b26439-ai/Siddarth-lmsbot/Task3_PID_Control.docx

# Task 3 — PID Control

How PID applies to line following, and why this robot uses PD

Summary: PID control steers the robot by turning "how far the line is from the centre" into "how much faster one wheel should turn than the other". For this robot we use PD: proportional plus derivative, with the integral term set to zero. The implementation is in Task 9 (task9_line_follower.ino); this document explains the reasoning.

# 1. The control problem

The goal is to keep the line under the centre sensor. The error is the difference between where the line is and where we want it:

error = line position − target = position − 0

The line position comes from the weighted centroid of the five sensors (Task 1): −2 means the line is under the far-left sensor, 0 centred, +2 far right. A positive error means the line is to the right, so the robot must turn right.

# 2. The role of P, I and D

Term | What it reacts to | Effect on the robot | Too much / too little
P (proportional) | The present error: how far off-centre the line is now | Steers in proportion to the offset: a small drift gives a small turn, a big drift a big turn | Too much: fast side-to-side wobble and overshoot. Too little: slow, wide corners; can lose the line
I (integral) | The sum of all past errors | Removes a constant offset, such as one motor always being slightly weaker | Builds up on long curves, then overshoots on the next turn ("wind-up"); makes the robot sluggish to settle
D (derivative) | How fast the error is changing | Acts as a brake on the turn: as the robot swings back toward the line, the error shrinks fast, and D pushes the other way to stop it overshooting | Too much: twitchy, reacts to sensor noise. Too little: P's wobble is not damped

An analogy: steering a bicycle to follow a painted line. P is "turn the handlebar according to how far you are from the line". D is "if you are already heading back toward it quickly, ease off the handlebar so you don't cross over". I is "if you keep finding yourself slightly left, add a permanent nudge right".

# 3. Which configuration and why: PD

Option | Behaviour on a line follower | Verdict
P only | Follows the line but oscillates, especially at speed, because nothing damps the swing | Too wobbly for 90° junctions about 30 cm apart
PD | P steers, D damps; stable at higher speed and settles quickly after corners | Chosen
Full PID | I removes steady offsets, but a line follower rarely has one; the summed error winds up on curves and causes overshoot | Not needed; I kept in code with Ki = 0

The Task 9 code still contains the I term (KI = 0). If testing shows the robot always drifting to one side, because the two motors are not perfectly matched (likely without encoders), a small Ki such as 0.5 can be added. The integral is reset whenever the line is lost and found again.

# 4. From sensor readings to motor commands

1. Read and scale: each sensor's raw value (0–4095) is calibrated to 0–1000, where 1000 means directly over the line.
2. Position: weighted centroid = Σ(weight × reading) / Σ(readings), with weights −2, −1, 0, +1, +2.
3. Error: position − 0.
4. Correction: u = Kp × error + Ki × (sum of errors) + Kd × (error − previous error).
5. Wheel commands: left = base + u, right = base − u. A line to the right (positive u) speeds up the left wheel and slows the right, so the robot turns right toward the line.
6. Limit: if either command exceeds 255, both are scaled down by the same factor, so the turn is preserved.
7. Drive: the sign of each command sets the motor's direction pins, and its size sets the PWM speed.

## Worked example (Kp = 50, Ki = 0, Kd = 60, base = 150)

Step | Value
Scaled readings S1…S5 | 0, 0, 200, 1000, 200 (the line is under S4)
Position | (−2·0 − 1·0 + 0·200 + 1·1000 + 2·200) / 1400 = 1400 / 1400 = +1.000
Error | +1.000 (previous error was 0)
Correction u | 50 × 1.000 + 60 × (1.000 − 0) = 110
Wheel commands | left = 150 + 110 = 260, right = 150 − 110 = 40
Proportional limit | 260 > 255, so both × 255/260: left 255, right 39 → a firm right turn

# 5. Responding to oscillation

Symptom | Likely cause | Response
Fast wobble around the line | Kp too high | Lower Kp by 20–30%, or raise Kd
Slow, growing swings that overshoot corners | Kd too low | Raise Kd in steps of about 20
Jittery motors even on a straight line | Kd too high (amplifying sensor noise) | Lower Kd
Fine when slow, unstable when fast | Base speed too high for the gains | Lower the base speed, or re-tune at the new speed
Behaviour changes from run to run | Loop timing not fixed (D depends on it) or battery voltage changing | Keep a fixed loop period (10 ms); start every run on a charged battery

Tuning order: set Kd = 0 and raise Kp until the robot follows with a quick, small wobble. Then raise Kd until the wobble disappears. Then increase the base speed and repeat.

# 6. Responding to a lost line

- Detection: if the five scaled readings add up to less than 200, no sensor can see the line. The centroid is not calculated, which also avoids dividing by zero.
- Recovery: the robot remembers which side the line was last seen on and spins toward it at a fixed speed (PWM 120). This catches the common case of overshooting a sharp corner.
- Safe stop: if the line is not found within 300 ms, both motors stop rather than letting the robot wander off the arena.
- Re-acquiring: when the line reappears, the PID memory (previous error and integral) is reset. Otherwise the jump in error would produce a sudden derivative kick.

# 7. Code sketch

The core of the implementation (full program and test results in Task 9):

float computePID(float error) {

integral += error; // I: running sum (Ki = 0 here)

float derivative = error - lastError; // D: change since the last loop

lastError = error;

return KP * error + KI * integral + KD * derivative;

}

// inside controlStep(), when the line is found:

float error = position; // target is 0 (centred)

float correction = computePID(error);

float leftCmd = BASE_SPEED + correction;

float rightCmd = BASE_SPEED - correction;

clampSpeed(leftCmd, rightCmd); // proportional limit to 255

left = round(leftCmd); // loop() then calls

right = round(rightCmd); // driveMotors(left, right)

Task 3 — PID Control · page 1
