b26439-ai/Siddarth-lmsbot/Task5_Power_Budget.docx

# Task 5 — Power Budget & Battery Selection

LMS / Meshmerize robot, system as in the Task 4 BOM

Result: the robot draws about 0.57 A in a typical run and at most about 2.22 A if both motors stall (3.42 A with a pessimistic motor). The 2S 1000 mAh 30C LiPo runs it for about 78 minutes per charge, while one 5.5-minute match uses only about 53 mAh (5% of the pack). The pack can deliver 30 A, about 9× the worst case.

# 1. System and assumptions

Power path: 2S LiPo → XT60 → 3 A fuse → switch. The battery feeds the TB6612FNG motor supply (VM) directly, and feeds an MP1584 buck set to 5.0 V for the ESP32's 5V pin. The ESP32 board's regulator then makes 3.3 V for the ESP32, the Pololu QTRX-MD-08RC sensor, the TB6612FNG logic and the LED.

- Battery voltage: 7.4 V nominal (8.4 V full, 6.0 V empty). Totals use 7.4 V.
- Buck efficiency η = 85% (assumption; switching regulators of this type are typically 85–90%).
- 3.3 V loads pass through a linear regulator, so its input current equals its output current plus its own quiescent current. Every 3.3 V load is therefore also a 5 V load at the same current.
- Motor current is counted at the battery as if PWM were 100%. PWM (capped at about 71%) actually lowers the average battery current, so this is a safe overestimate.
- Derating factor 0.75 for runtime (from the task brief): batteries never deliver their full label capacity, and a LiPo should not be drained below about 3.0 V per cell.
- Figures marked (est.) are estimates to be replaced by multimeter measurements once the robot is built.

# 2. Current draw per component

Idle = powered on, motors stopped. Running = following the line. Peak = Wi-Fi transmitting, LED on and motors stalled.

Component | Rail | Idle (mA) | Running (mA) | Peak / stall (mA) | Basis
ESP32 chip | 3.3 V | 68 | 68 (Wi-Fi off) / 100 (Wi-Fi on) | 240 | Espressif figures via JLCPCB (https://jlcpcb.com/blog/esp32-power-consumption-explained): CPU 240 MHz radio off 30–68 mA; Wi-Fi receive 95–100 mA; Wi-Fi transmit peak 240 mA
ESP32 board overhead | 3.3 V / 5 V | 8 | 8 | 8 | Regulator quiescent ~5 mA, power LED ~1.3 mA, USB chip ~1.3 mA (JLCPCB (https://jlcpcb.com/blog/esp32-power-consumption-explained))
Pololu QTRX-MD-08RC | 3.3 V | 17 | 17 | 17 | Maximum board current, all LEDs on (MG Super Labs (https://www.mgsuperlabs.co.in/estore/QTRX-MD-08RC-Reflectance-Sensor-Array-8-Channel-8mm-Pitch-RC-Output-Low-Current))
TB6612FNG logic (VCC) | 3.3 V | 1.1 | 1.1 | 1.8 | ICC 1.1 mA typ, 1.8 mA max at 3 V (Toshiba (https://toshiba.semicon-storage.com/info/docget.jsp?did=10660) p. 5)
Red end-zone LED | 3.3 V | 0 | 0 | 3.9 | (3.3 − 2.0 V) / 330 Ω (est. LED drop 2.0 V)
5 V rail total | 5 V | 94.1 | 94.1 / 126.1 | 270.7 | Sum of the rows above
MP1584 buck → battery side | battery | 75 | 75 / 100 | 215 | 5 V × I₅ / (0.85 × 7.4 V)
Left N20 motor | battery | 0 | 250 (est.) | 1,000 | Stall 1 A for a GA12-N20 6 V 300 RPM (Handsontec (https://handsontec.com/index.php/product/ga12-n20-6v300rpm-geared-mini-dc-motor/)); running is an estimate; to be measured
Right N20 motor | battery | 0 | 250 (est.) | 1,000 | Same as left
TB6612FNG motor side | battery | ≈ 0 | ≈ 0 | ≈ 0 | Standby current ≤ 1 µA; operating overhead not specified, negligible next to the motors

## Converting 5 V loads to battery current

Power is conserved through the buck converter apart from its losses, so:

I_battery = (5 V × I_5V) / (η × V_battery)

Example, idle: (5 × 0.0941 A) / (0.85 × 7.4 V) = 0.4705 W / 6.29 V = 0.075 A. The battery supplies less current than the 5 V rail draws because its voltage is higher.

# 3. Totals at the battery

Scenario | Battery current | What it represents
Idle | 0.075 A | Powered on, calibrated, waiting for the start button
Typical run (competition, Wi-Fi off) | 0.575 A | Logic 0.075 A + two motors at 0.25 A
Practice run with Wi-Fi telemetry | 0.600 A | Wi-Fi adds about 25 mA on average
Worst case: both motors stalled + Wi-Fi transmitting | 2.215 A | 2 × 1.0 A stall + 0.215 A logic peak
Upper bound (Pololu high-power motor, 1.6 A stall) | 3.415 A | Pessimistic case using Pololu 6 V HP (https://www.pololu.com/product/999/specs) figures

At the empty-battery voltage of 6.0 V the logic draws slightly more battery current (about 0.27 A peak instead of 0.22 A), because the buck must pull more current from a lower voltage. This changes the worst case by only about 0.05 A.

# 4. Runtime

Using the formula from the task brief:

Runtime (h) = Capacity (mAh) / Average current (mA) × 0.75

Scenario | Current | Runtime | Working
Typical competition run | 575 mA | 1.30 h ≈ 78 min | 1000 / 575 × 0.75
Practice with Wi-Fi telemetry | 600 mA | 1.25 h ≈ 75 min | 1000 / 600 × 0.75
Idle (waiting) | 75 mA | 10.03 h | 1000 / 75 × 0.75
Continuous double stall (never happens in practice) | 2215 mA | 0.34 h ≈ 20 min | 1000 / 2215 × 0.75

Energy cross-check: the pack stores 7.4 V × 1.0 Ah = 7.4 Wh. A typical run uses 7.4 V × 0.575 A = 4.25 W, so 7.4 Wh × 0.75 / 4.25 W = 1.30 h, which matches.

What it means: one Meshmerize match (3 min dry run + 2.5 min actual run) uses about 53 mAh. Capacity is never the limit. What matters is starting every match on a fully charged pack, so that the motors see the same voltage and the tuned PID behaves the same.

# 5. Checks against component ratings

Check | Demand | Rating | Result
Battery maximum discharge (1.0 Ah × 30C) | 3.42 A | 30 A | OK, about 9× margin
Fuse | 2.22 A | 3 A | OK; it blows only on a short (or a 1.6 A-per-motor double stall)
TB6612FNG per channel | 1.0 A stall | 1.0 A operating, 1.2 A absolute max | OK; firmware stall timeout as backup (Task 2)
MP1584 output | 271 mA | 3 A | OK, large margin
ESP32 board regulator heat | (5 − 3.3) V × 271 mA | — | 0.46 W peak, 0.16 W typical: fine

# 6. Battery chemistry: LiPo vs Li-ion (18650)

Both options give a nominal 7.4 V pack (2 cells in series), which suits the TB6612FNG and the 6 V motors.

Factor | 2S LiPo, 1000 mAh 30C (chosen) | 2S Li-ion, 2 × Samsung 25R 18650
Capacity / energy | 1000 mAh, 7.4 Wh | 2500 mAh, 18 Wh (3.6 V × 2.5 Ah × 2)
Weight | ≈ 57 g (comparable 2S 1000 mAh 30C pack, Overlander (https://overlander.co.uk/lipo-batteries/lipo-batteries-1000mah-7-4v-2s-30c.html)) | 2 × 45 g = 90 g, plus a holder (~20 g, est.) ≈ 110 g (18650 Battery Store (https://www.18650batterystore.com/products/samsung-25r-18650))
Energy density | 7.4 Wh / 0.057 kg ≈ 130 Wh/kg | 9.0 Wh / 0.045 kg ≈ 200 Wh/kg per cell; ≈ 164 Wh/kg with holder
Maximum continuous current | 30C × 1 Ah = 30 A | 20 A per cell (≈ 8C)
Voltage under load | Highest of the lithium types: least sag when motors surge | Sags more under high current
Cost (India) | ₹1,099 (Robu (https://robu.in/product-category/2-cell-lipo-7-4v-8-4v/), 21 Oct) | ≈ ₹840 for two cells (US$4.99 each, converted, est.) + ₹59 holder (Probots (https://probots.co.in/2-x-battery-holder-for-18650-lithium-ion-plastic.html))
Safety | Soft pouch: can swell or catch fire if punctured or over-discharged | Steel can: tougher against crashes
Cycle life | Lower: about half that of Li-ion | Higher
Fit on a 130 × 150 mm robot | Flat 56 × 30 × 19 mm pack sits low over the axle | Two 65 mm cylinders: taller and harder to place low

Qualitative points (voltage under load, safety, cycle life) follow Unmanned Systems Technology (https://www.unmannedsystemstechnology.com/feature/lipo-vs-lithium-ion-batteries-for-unmanned-robotics-applications/); C-rate meaning follows Battery University BU-402 (https://batteryuniversity.com/article/bu-402-what-is-c-rate).

## Why we chose the LiPo

1. Weight: about 57 g against about 110 g. On a robot that brakes and pivots at junctions about 30 cm apart, half the battery weight means faster stops and more accurate turns.
2. Current margin and voltage stability: 30 A available against a 3.4 A worst case, with the least voltage sag. Steadier motor voltage keeps the PID tuning consistent.
3. Energy density is not the deciding factor. Li-ion stores more energy per kg, but we need only about 53 mAh per match. Extra capacity is just extra weight we would carry.
4. Cost is similar: ₹1,099 against about ₹900 for cells and a holder. The ~₹200 saving doesn't outweigh the weight.
5. Packaging: the flat pack mounts low over the drive axle, keeping the centre of mass low and the weight on the drive wheels.

Accepted trade-off and how we handle it: LiPo is less robust and has fewer cycles. We charge only with the balance charger inside the fire-safe bag, never discharge below 3.0 V per cell (checked with a multimeter before runs), store at about 3.8 V per cell, and retire any pack that swells.

Task 5 — Power Budget & Battery Selection · page 1
