b26439-ai/Siddarth-lmsbot/task_2_final.docx

# Task 2 — Datasheet Literacy

Motor driver: Toshiba TB6612FNG, compared with the ST L298N

Component chosen: the Toshiba TB6612FNG dual H-bridge, the motor driver in our BOM (Task 4). It drives two 6 V N20 gear motors from a 2S LiPo (7.4 V nominal, 8.4 V fully charged), with an ESP32 (3.3 V logic) as the controller.

Why this component: the motor driver is the active part whose limits most directly shape the battery, the wiring and the firmware. It is also the part that differs most from Appendix A, which specifies an L298N on a 3S pack.

Sources: Toshiba TB6612FNG datasheet, rev. 2008-05-09 (https://toshiba.semicon-storage.com/info/docget.jsp?did=10660) ; STMicroelectronics L298 datasheet, January 2000 (https://www.makerguides.com/wp-content/uploads/2019/07/L298N-Datasheet.pdf)

# 1. TB6612FNG at a glance

Parameter | Value
Motor supply VM, operating / absolute max | 2.5–13.5 V / 15 V
Logic supply VCC, operating | 2.7–5.5 V
Output current per channel | 1.0 A operating (VM ≥ 4.5 V); 1.2 A absolute max average
Pulsed output current | 2 A (20 ms pulses, duty ≤ 20%); 3.2 A (single 10 ms pulse)
Output voltage drop, upper + lower switch | 0.15 V typ at 0.3 A; 0.5 V typ (0.7 V max) at 1 A
Input high threshold VIH | ≥ 0.7 × VCC
Input current (logic pins) | 5–25 µA
Logic supply current | 1.1 mA typ at VCC = 3 V
Maximum PWM frequency | 100 kHz
Power dissipation, IC only | 0.78 W (0.89 W on a 50 × 50 mm PCB)
Protection | Thermal shutdown 175 °C; undervoltage lockout 1.9 V; STBY has an internal 200 kΩ pull-down

# 2. Three parameters that constrain our design

## A. Motor supply voltage VM: 2.5–13.5 V (absolute max 15 V) → 2S battery, not 3S

- A 2S LiPo is 8.4 V fully charged, leaving 5.1 V of margin below the 13.5 V operating limit for back-EMF spikes and charger tolerance.
- A 3S LiPo (as in Appendix A) is 12.6 V fully charged: only 0.9 V below the operating limit and 2.4 V below the absolute maximum. A spike when a motor brakes or reverses could exceed it.
- Decision: use a 2S pack. The motors are rated 6 V, so the firmware caps PWM duty at 6.0 / V_battery (about 71% on a full pack) to keep the average motor voltage near 6 V.

## B. Output current: 1.0 A operating, 1.2 A absolute max, 2 A for 20 ms , firmware current limits

Motor state (one N20) | Current | Against the TB6612FNG
Running on the flat (estimate) | 0.15–0.3 A | Well inside 1.0 A
Start-up surge or stall (Pololu 6 V HP class used as an upper bound; to be measured) | ≈ 1.6 A | Above the 1.2 A average limit, but within the 2 A / 20 ms pulse rating

A start-up surge lasts a few tens of milliseconds and fits the pulse rating. A sustained stall, such as the robot pushing against a wall, does not. Decisions:

1. Ramp the PWM duty from 0 to the target over about 50–80 ms, so start-up current stays a short pulse.
2. Add a stall timeout: if the sensor pattern does not change while duty stays above 40% for 1 s, switch the motors off.
3. Fit a fuse in the battery lead, as the datasheet recommends against over-current (TB p. 9).
4. Give each motor its own channel, with no other loads on the driver.

## C. Logic supply and input threshold: VIH ≥ 0.7 × VCC → power the logic from 3.3 V

- With VCC = 3.3 V, VIH = 0.7 × 3.3 = 2.31 V. The ESP32's 3.3 V outputs clear this easily, and each input draws only 5–25 µA (TB p. 5), so the GPIO is barely loaded.
- With VCC = 5 V, VIH = 3.5 V. A 3.3 V ESP32 pin can never reach that, so the driver would ignore commands or act unpredictably.
- Decision: connect the TB6612FNG's VCC to the ESP32's 3.3 V rail. It needs only about 1.1 mA, and no level shifter is required.
- Related limits: we run PWM at 20 kHz, above hearing and well under the 100 kHz maximum . The STBY pin's internal pull-down keeps the outputs off while the ESP32 boots, and the firmware holds STBY low until setup has finished.

# 3. A rating that would damage the part, and how we avoid it

Condition: sustained current above the 1.2 A per-channel absolute maximum, and the heat it produces. The package can dissipate only 0.78 W (TB p. 3). The output switches drop about 0.5 V at 1 A (TB p. 5), roughly 0.5 Ω in total.

At a 1.6 A stall, each channel dissipates P = I² × R = 1.6² × 0.5 ≈ 1.3 W. With both motors stalled that is about 2.6 W, more than three times what the package can shed. The 175 °C thermal shutdown is a last resort, and the datasheet itself says it does not always protect the IC (TB p. 10). Absolute-maximum ratings are limits that must never be exceeded, not operating points.

Risk | How the design avoids it
Sustained stall current | Stall timeout (1 s) and PWM ramp in firmware; duty cap for a 6 V average
Current higher than expected | Measure each motor's stall current at 6 V on a bench supply before final assembly. If it exceeds about 1.5 A, switch to a driver with built-in current limiting (e.g. TI DRV8833)
Voltage spikes on VM (the other damage path: VM > 15 V) | 2S battery (8.4 V max). 470 µF bulk plus 0.1 µF ceramic at VM, exceeding the datasheet's 10 µF + 0.1 µF placed close to the IC (TB p. 7). 0.1 µF across each motor's terminals
Wiring short | Fuse in the battery lead (TB p. 9)

Task 2 — Datasheet Literacy · page 1
