b26439-ai/Siddarth-lmsbot/task4_power_block_diagram.png

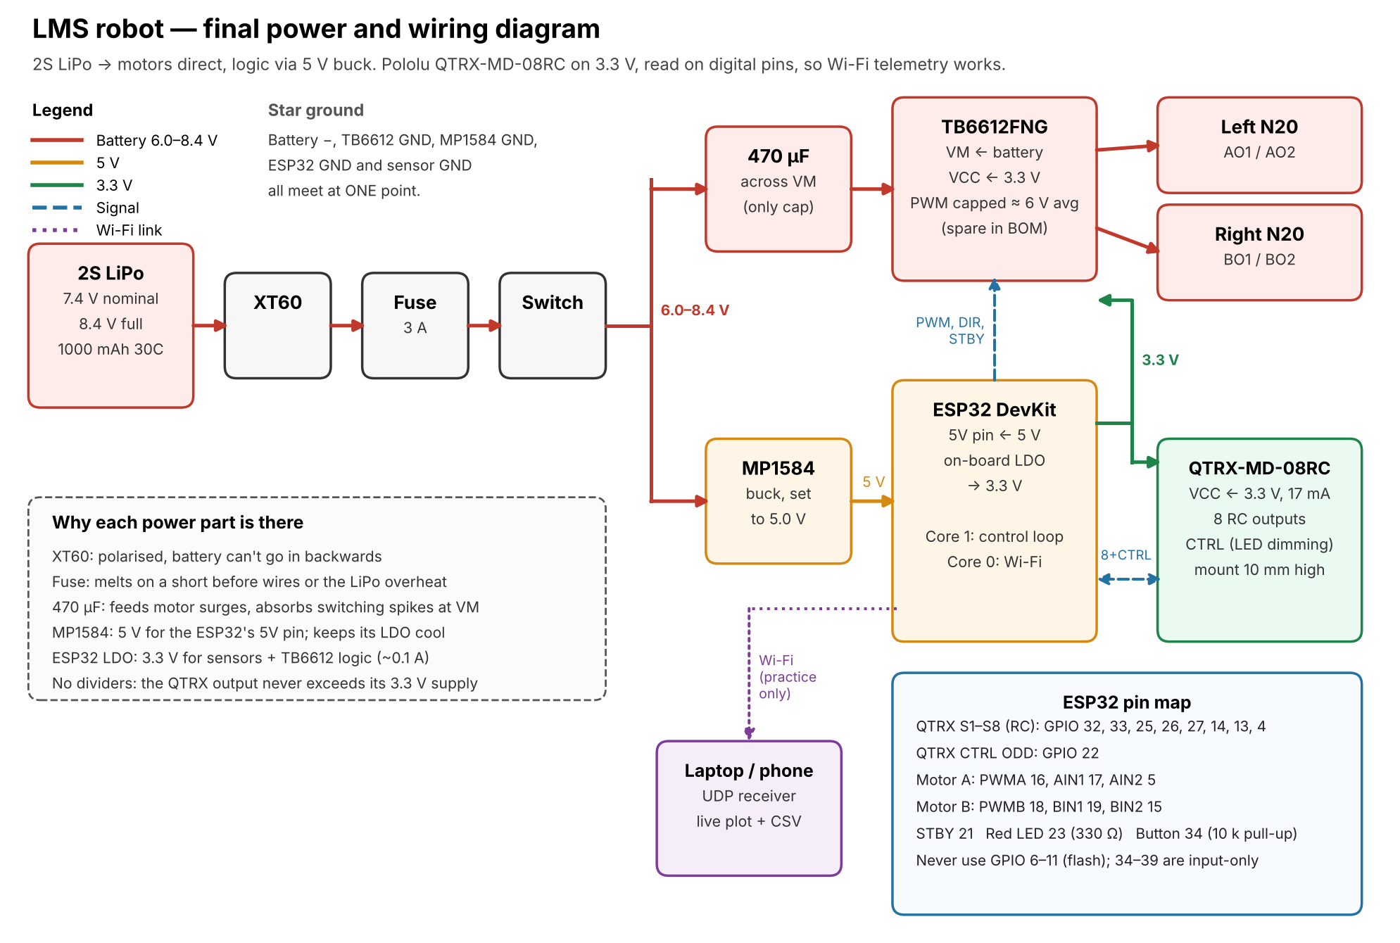
task4_power_block_diagram.png
