b26439-ai/Siddarth-lmsbot/Task4_BOM.xlsx

Task 4 - Bill of Materials: LMS robot (2WD)
Prices in Rs, including GST, read on supplier pages on the date shown. Blue cells are inputs. Final version: QTRX sensor, no dividers, no mux, spare driver kept.
# | CATEGORY | COMPONENT | OTY | UNIT PRICE | TOTAL PRICE | SUPPLIER(DATE) | LINK
1 | Controller | ESP32-WROOM-32 38-pin DevKit | 1 | 449 | 449 | Robu (21 Oct) | Open (https://robu.in/product/esp32-38pin-development-board-wifibluetooth-ultra-low-power-consumption-dual-core/)
2 | Motors | N20 6 V 300 RPM micro metal gear motor (no encoder) | 3 | 261 | 783 | Robu (21 Oct) | Open (https://robu.in/product/n20-6v-300-rpm-micro-metal-gear-motor/)
3 | Motors | N20 plastic motor mount (black) | 2 | 35 | 70 | Probots (25 Oct) | Open (https://probots.co.in/black-n20-plastic-motor-fixed-seat.html)
4 | Wheels | 3pi / MiniQ 42 mm wheel for N20 (18 mm tyre) | 2 | 59 | 118 | Probots (25 Oct) | Open (https://probots.co.in/3pi-miniq-car-wheel-tyre-42mm-for-n20-motor.html)
5 | Wheels | Ball castor wheel | 1 | 39 | 39 | Probots (25 Oct) | Open (https://probots.co.in/castor-wheel.html)
6 | Driver | TB6612FNG dual motor driver module | 2 | 284 | 568 | Robokits (21 Oct) | Open (https://robokits.co.in/motor-drives-drivers/dc-motor-driver/tb6612fng-ultra-small-dual-dc-motor-driver-module)
7 | Sensors | Pololu QTRX-MD-08RC reflectance array (8-ch, 8 mm pitch, RC output) | 1 | 2129 | 2129 | MG Super Labs (25 Oct, backorder 2-3 wk) | Open (https://www.mgsuperlabs.co.in/estore/QTRX-MD-08RC-Reflectance-Sensor-Array-8-Channel-8mm-Pitch-RC-Output-Low-Current)
8 | Power | Pro-Range 7.4 V 1000 mAh 30C 2S LiPo | 1 | 1099 | 1099 | Robu (21 Oct) | Open (https://robu.in/product-category/2-cell-lipo-7-4v-8-4v/)
9 | Power | iMax B3 AC 2S-3S balance charger | 1 | 329 | 329 | Makerbazar (21 Oct) | Open (https://makerbazar.in/products/imax-b3-ac-compact-balance-charger-for-2s-3s-lipo)
10 | Power | LiPo fire-safe bag | 1 | 300 | 300 | Local (estimate) | -
11 | Power | MP1584 3 A adjustable buck module | 2 | 79 | 158 | Probots (25 Oct) | Open (https://probots.co.in/mp1584-dc-dc-step-down-3a-adjustable-buck-module.html)
12 | Power | 470 uF 50 V electrolytic capacitor | 1 | 12 | 12 | Probots (25 Oct) | Open (https://probots.co.in/470uf-50v-electrolytic-capacitor.html)
13 | Power | XT60 connector pair | 1 | 39 | 39 | Probots (25 Oct) | Open (https://probots.co.in/xt60-connector-male-and-female-for-rc-lipo-battery.html)
14 | Power | KCD11 mini rocker switch, SPST | 1 | 15 | 15 | Probots (25 Oct) | Open (https://probots.co.in/rocker-switch-mini-on-off-spst-2-pin-kcd11.html)
15 | Power | 3 A glass fuse, 5 x 20 mm | 2 | 39 | 78 | Probots (25 Oct) | Open (https://probots.co.in/3a-250vac-fuse-glass-tube-5x20mm.html)
16 | Power | 5 x 20 mm PCB fuse holder | 1 | 49 | 49 | Probots (25 Oct, out of stock) | Open (https://probots.co.in/fuse-holder-with-transparent-cover-for-5x20mm-fuses-pcb-mount.html)
17 | Control | Tactile push button 6 x 6 x 10 mm (pack) | 1 | 30 | 30 | Zbotic (25 Oct) | Open (https://zbotic.in/?p=457730)
18 | Control | 5 mm red LED, diffused | 2 | 4 | 8 | Probots (25 Oct) | Open (https://probots.co.in/5mm-red-led-diffused.html)
19 | Misc | Resistors: 330 ohm (LED) + 10 k (button pull-up) | 1 | 10 | 10 | Local (estimate) | -
20 | Chassis | 3 mm acrylic plate, ~130 x 150 mm | 1 | 300 | 300 | Local (estimate) | -
21 | Misc | Wire, headers, perfboard, M3 standoffs, screws, heat-shrink | 1 | 400 | 400 | Local (estimate) | Open (https://aws.robu.in/product-category/batteries/wires-and-cables/silicone-wires/18-to-22-awg)
22 | Shipping | About 5 orders (Robu, Probots, Robokits, MG Super Labs, Makerbazar) | 1 | 500 | 500 | Estimate | -
 |  |  |  | Subtotal | 7483
 |  |  |  | Contingency rate | 15% | 15% covers price changes and a broken part
 |  |  |  | Contingency | 1122.45
 |  |  |  | Grand total | 8605.45
 |  |  |  | Budget limit | 10000 | Task limit
 |  |  |  | Remaining | 1394.55
